ganymede451/kurc-f405/docs/kurc_f405_schematic.pdf

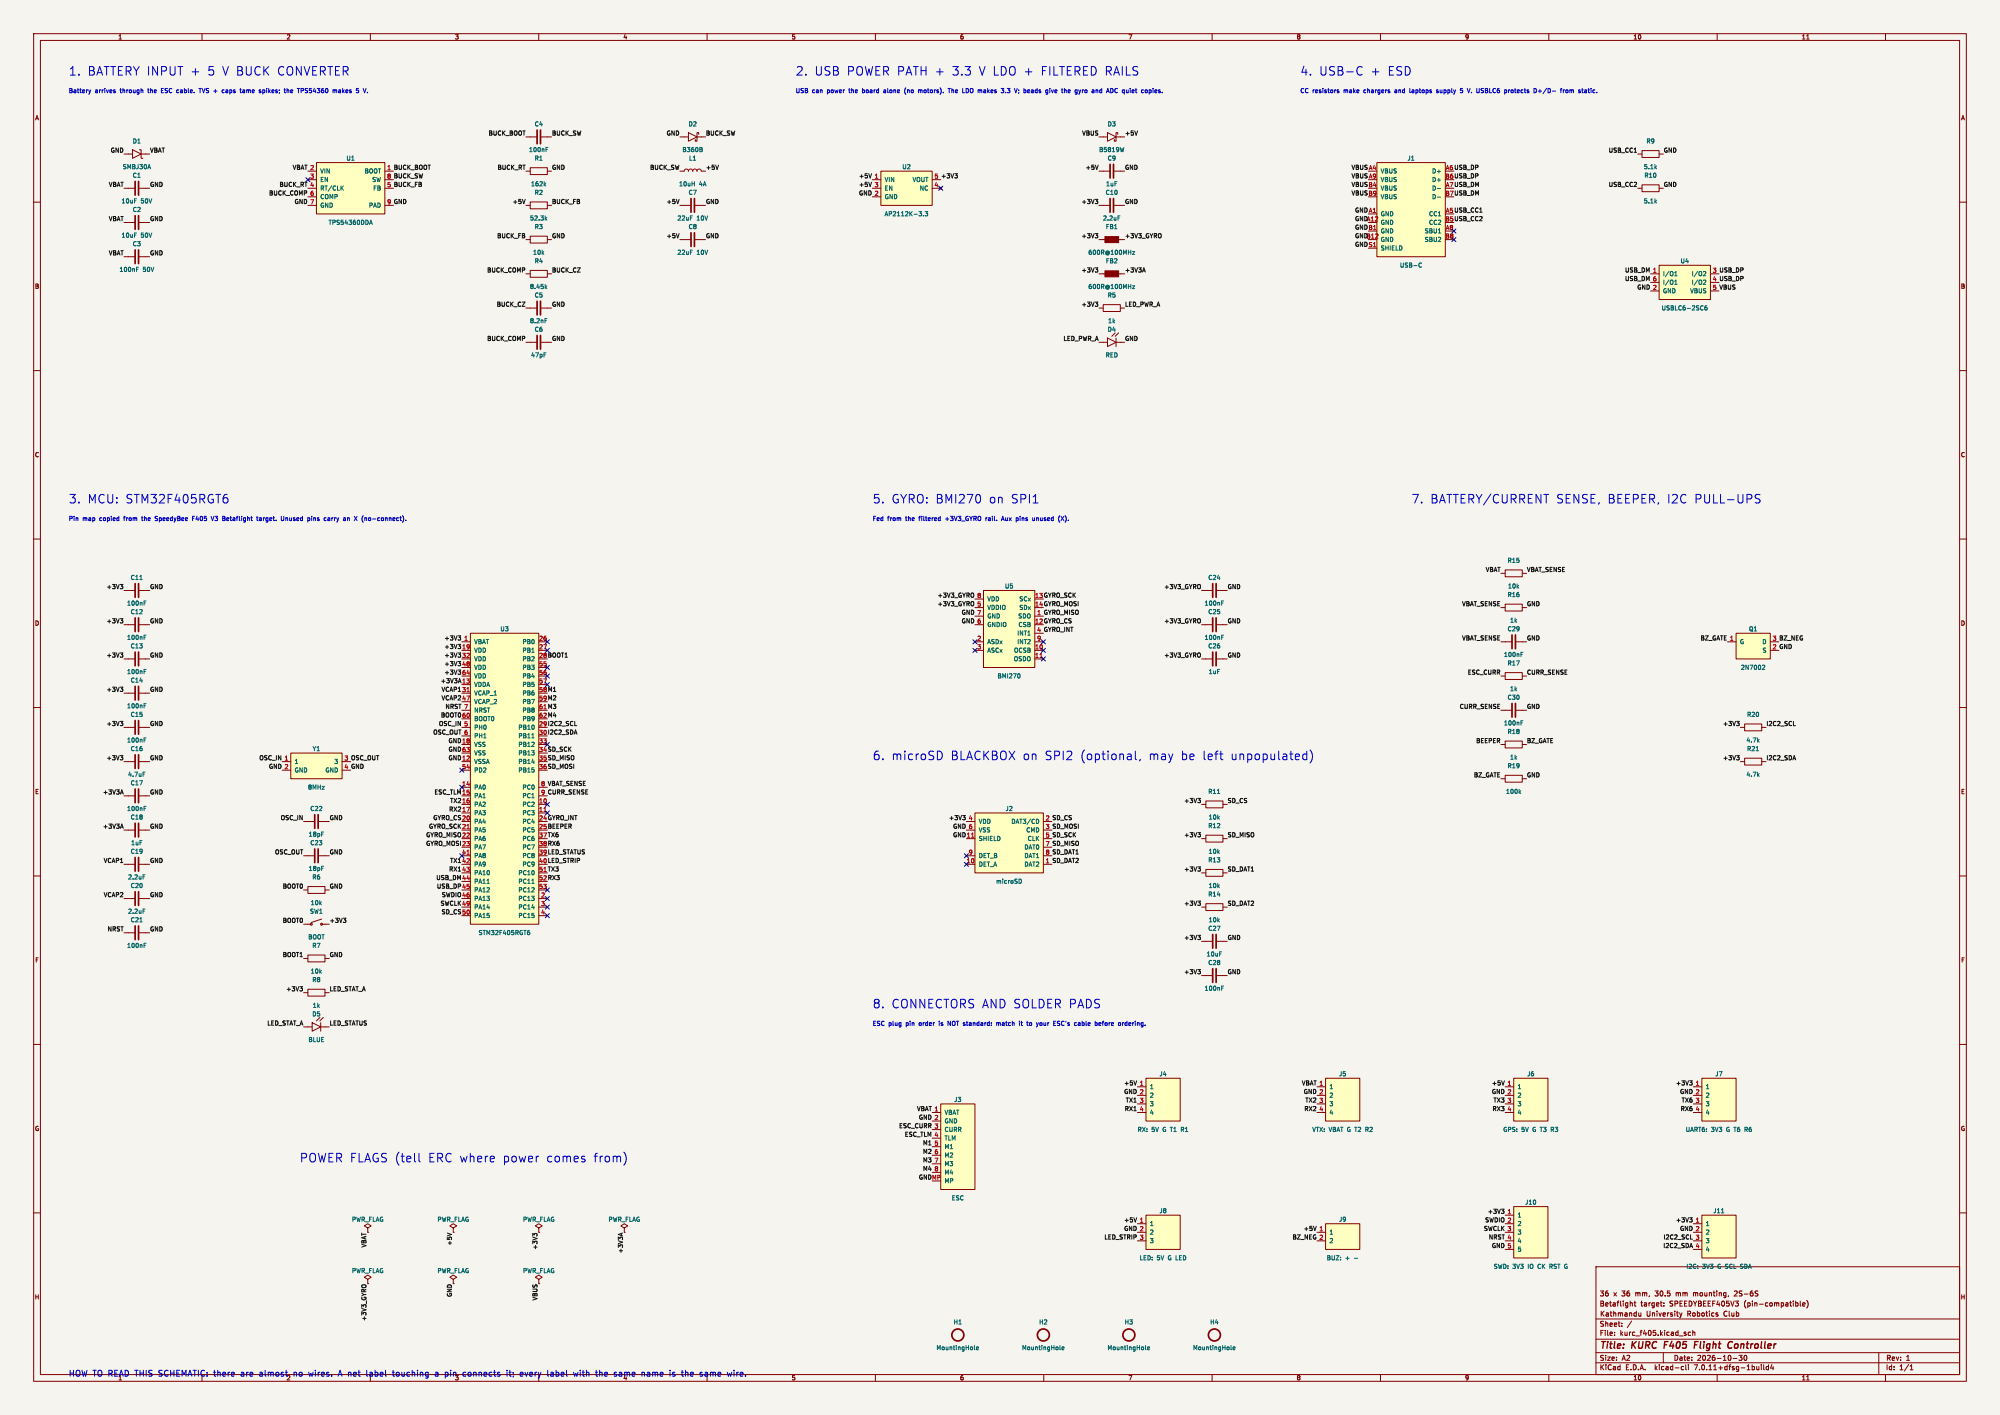
[picture p1: page 1]

1. BATTERY INPUT + 5 V BUCK CONVERTER

GND
GND GND

100k VBAT 1 GND 2 CURR 3 TLM 4 M1 5 M2 6 M3 7 M4 8 MP MP
J2 microSD

8. CONNECTORS AND SOLDER PADS

POWER FLAGS (tell ERC where power comes from)
