ganymede451/kurc-f405/hardware/kurc_f405.kicad_pcb

## KiCad design hardware/kurc_f405.kicad_pcb (2026-11-01)

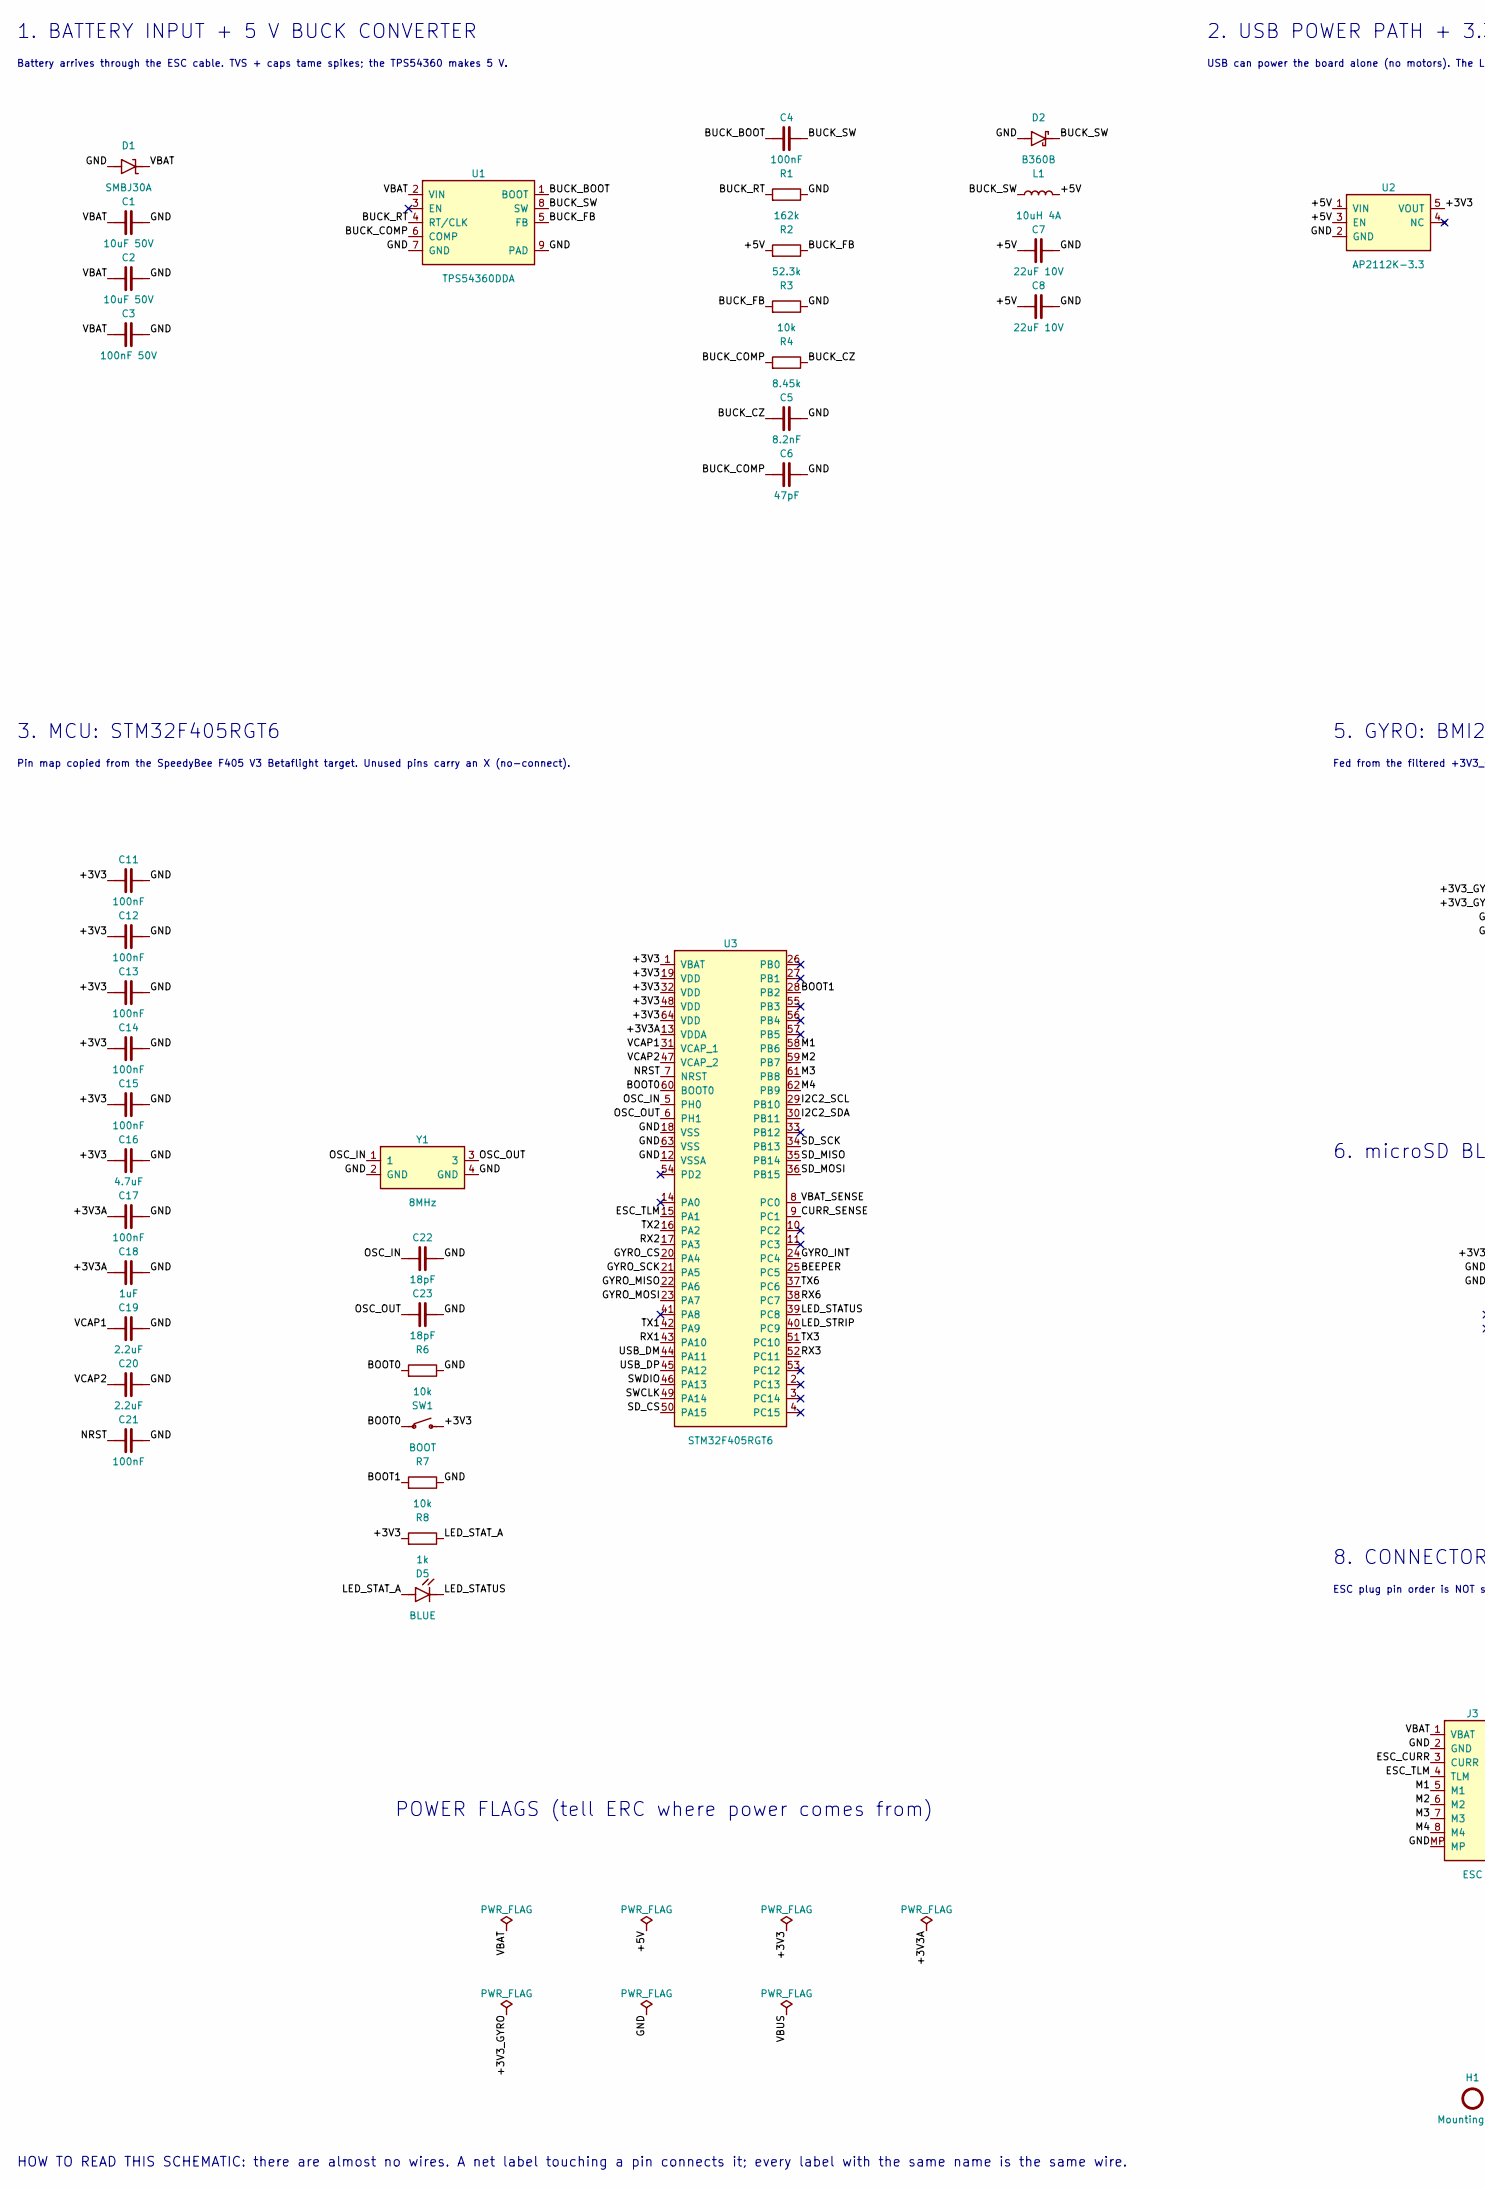
[picture p2: schematic kurc_f405.kicad_sch, KURC F405 Flight Controller, part in row 1, column 1]

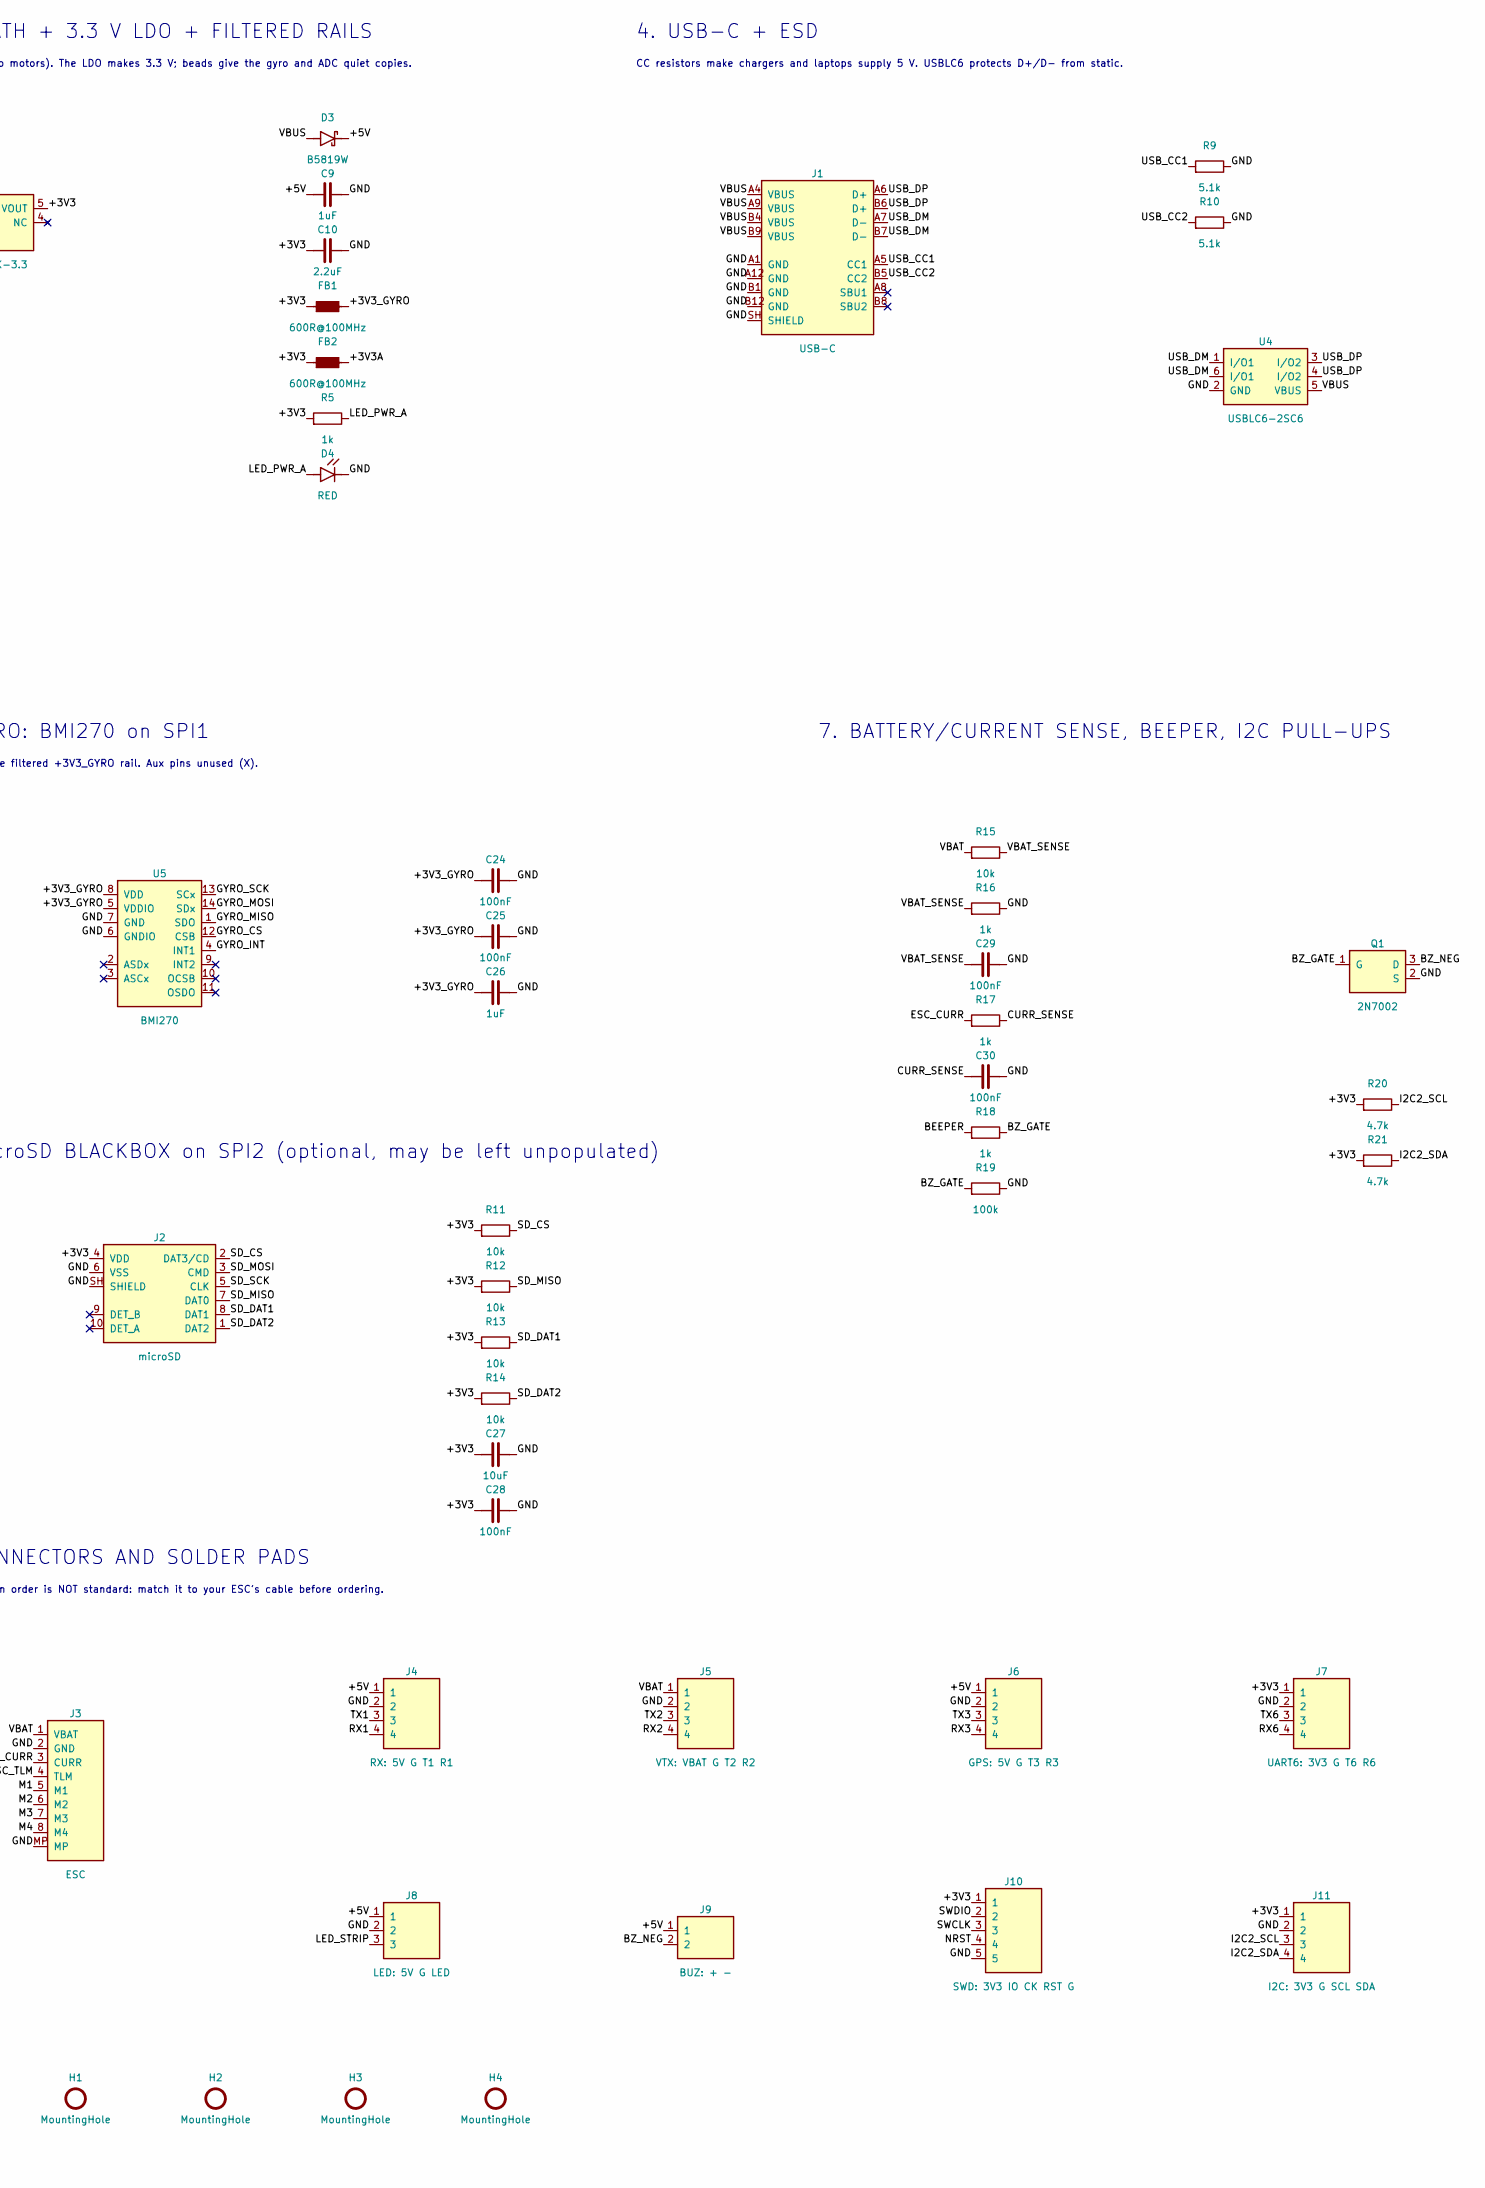
[picture p3: schematic kurc_f405.kicad_sch, KURC F405 Flight Controller, part in row 1, column 2]

Parts:
C1, C2: 10uF 50V; C_1206_3216Metric; MPN 1206 10uF 50V X7R/X5R
C3: 100nF 50V; C_0603_1608Metric; MPN 0603 100nF 50V X7R/X5R
C4: 100nF; C_0603_1608Metric; MPN 0603 100nF X7R/X5R
C5: 8.2nF; C_0402_1005Metric; MPN 0402 8.2nF X7R/X5R
C6: 47pF; C_0402_1005Metric; MPN 0402 47pF X7R/X5R
C7, C8: 22uF 10V; C_0805_2012Metric; MPN 0805 22uF 10V X7R/X5R
C9, C18, C26: 1uF; C_0603_1608Metric; MPN 0603 1uF X7R/X5R
C10, C19, C20: 2.2uF; C_0603_1608Metric; MPN 0603 2.2uF X7R/X5R
C11, C12, C13, C14, C15, C17, C21, C24, C25, C28, C29, C30: 100nF; C_0402_1005Metric; MPN 0402 100nF X7R/X5R
C16: 4.7uF; C_0603_1608Metric; MPN 0603 4.7uF X7R/X5R
C22, C23: 18pF; C_0402_1005Metric; MPN 0402 18pF X7R/X5R
C27: 10uF; C_0805_2012Metric; MPN 0805 10uF X7R/X5R
D1: SMBJ30A; D_SMB; MPN SMBJ30A
D2: B360B; D_SMB; MPN B360B-13-F
D3: B5819W; D_SOD-123; MPN B5819W
D4: RED; LED_0603_1608Metric; MPN 0603 red LED
D5: BLUE; LED_0603_1608Metric; MPN 0603 blue LED
FB1, FB2: 600R@100MHz; L_0603_1608Metric; MPN BLM18PG601SN1D
H1, H2, H3, H4: MountingHole; MountingHole_4.0mm_Grommet
J1: USB-C; USB_C_Receptacle_HRO_TYPE-C-31-M-12; MPN HRO TYPE-C-31-M-12
J2: microSD; microSD_HC_Hirose_DM3AT-SF-PEJM5; MPN Hirose DM3AT-SF-PEJM5
J3: ESC; JST_SH_SM08B-SRSS-TB_1x08-1MP_P1.00mm_Horizontal; MPN JST SM08B-SRSS-TB
J4: RX: 5V G T1 R1; SolderPads_1x04_P2.54mm
J5: VTX: VBAT G T2 R2; SolderPads_1x04_P2.54mm
J6: GPS: 5V G T3 R3; SolderPads_1x04_P2.54mm
J7: UART6: 3V3 G T6 R6; SolderPads_1x04_P2.54mm
J8: LED: 5V G LED; SolderPads_1x03_P2.54mm
J9: BUZ: + -; SolderPads_1x02_P2.54mm
J10: SWD: 3V3 IO CK RST G; SolderPads_1x05_P2.54mm
J11: I2C: 3V3 G SCL SDA; SolderPads_1x04_P2.54mm
L1: 10uH 4A; L_Bourns_SRN8040TA; MPN SRN8040TA-100M
Q1: 2N7002; SOT-23; MPN 2N7002
R1: 162k; R_0603_1608Metric; MPN 0603 162k 1%
R2: 52.3k; R_0603_1608Metric; MPN 0603 52.3k 1%
R3, R6, R7, R11, R12, R13, R14, R15: 10k; R_0603_1608Metric; MPN 0603 10k 1%
R4: 8.45k; R_0603_1608Metric; MPN 0603 8.45k 1%
R5, R8, R16, R17, R18: 1k; R_0603_1608Metric; MPN 0603 1k 1%
R9, R10: 5.1k; R_0603_1608Metric; MPN 0603 5.1k 1%
R19: 100k; R_0603_1608Metric; MPN 0603 100k 1%
R20, R21: 4.7k; R_0603_1608Metric; MPN 0603 4.7k 1%
SW1: BOOT; SW_SPST_PTS810; MPN C&K PTS810 SJM 250 SMTR LFS
U1: TPS54360DDA; TI_SO-PowerPAD-8_ThermalVias; MPN TPS54360DDAR
U2: AP2112K-3.3; SOT-23-5; MPN AP2112K-3.3TRG1
U3: STM32F405RGT6; LQFP-64_10x10mm_P0.5mm; MPN STM32F405RGT6
U4: USBLC6-2SC6; SOT-23-6; MPN USBLC6-2SC6
U5: BMI270; Bosch_LGA-14_3x2.5mm_P0.5mm; MPN BMI270
Y1: 8MHz; Crystal_SMD_3225-4Pin_3.2x2.5mm; MPN 8 MHz 3225 crystal, CL 12 pF

Connections:
/+3V3: C10.1, C11.1, C12.1, C13.1, C14.1, C15.1, C16.1, C27.1, C28.1, FB1.1, FB2.1, J2.4 (VDD), J7.1, J10.1, J11.1, R5.1, R8.1, R11.1, R12.1, R13.1, R14.1, R20.1, R21.1, SW1.2, U2.5 (VOUT), U3.1 (VBAT), U3.19 (VDD), U3.32 (VDD), U3.48 (VDD), U3.64 (VDD)
/+3V3A: C17.1, C18.1, FB2.2, U3.13 (VDDA)
/+3V3_GYRO: C24.1, C25.1, C26.1, FB1.2, U5.5 (VDDIO), U5.8 (VDD)
/+5V: C7.1, C8.1, C9.1, D3.1 (K), J4.1, J6.1, J8.1, J9.1, L1.2, R2.1, U2.1 (VIN), U2.3 (EN)
/BEEPER: R18.1, U3.25 (PC5)
/BOOT0: R6.1, SW1.1, U3.60 (BOOT0)
/BOOT1: R7.1, U3.28 (PB2)
/BUCK_BOOT: C4.1, U1.1 (BOOT)
/BUCK_COMP: C6.1, R4.1, U1.6 (COMP)
/BUCK_CZ: C5.1, R4.2
/BUCK_FB: R2.2, R3.1, U1.5 (FB)
/BUCK_RT: R1.1, U1.4 (RT/CLK)
/BUCK_SW: C4.2, D2.1 (K), L1.1, U1.8 (SW)
/BZ_GATE: Q1.1 (G), R18.2, R19.1
/BZ_NEG: J9.2, Q1.3 (D)
/CURR_SENSE: C30.1, R17.2, U3.9 (PC1)
/ESC_CURR: J3.3 (CURR), R17.1
/ESC_TLM: J3.4 (TLM), U3.15 (PA1)
/GND: C1.2, C2.2, C3.2, C5.2, C6.2, C7.2, C8.2, C9.2, C10.2, C11.2, C12.2, C13.2, C14.2, C15.2, C16.2, C17.2, C18.2, C19.2, C20.2, C21.2, C22.2, C23.2, C24.2, C25.2, C26.2, C27.2, C28.2, C29.2, C30.2, D1.2 (A), D2.2 (A), D4.1 (K), J1.A1 (GND), J1.A12 (GND), J1.B1 (GND), J1.B12 (GND), J1.SH (SHIELD), J2.6 (VSS), J2.SH (SHIELD), J3.2 (GND), J3.MP, J4.2, J5.2, J6.2, J7.2, J8.2, J10.5, J11.2, Q1.2 (S), R1.2, R3.2, R6.2, R7.2, R9.2, R10.2, R16.2, R19.2, U1.7 (GND), U1.9 (PAD), U2.2 (GND), U3.12 (VSSA), U3.18 (VSS), U3.63 (VSS), U4.2 (GND), U5.6 (GNDIO), U5.7 (GND), Y1.2 (GND), Y1.4 (GND)
/GYRO_CS: U3.20 (PA4), U5.12 (CSB)
/GYRO_INT: U3.24 (PC4), U5.4 (INT1)
/GYRO_MISO: U3.22 (PA6), U5.1 (SDO)
/GYRO_MOSI: U3.23 (PA7), U5.14 (SDx)
/GYRO_SCK: U3.21 (PA5), U5.13 (SCx)
/I2C2_SCL: J11.3, R20.2, U3.29 (PB10)
/I2C2_SDA: J11.4, R21.2, U3.30 (PB11)
/LED_PWR_A: D4.2 (A), R5.2
/LED_STATUS: D5.1 (K), U3.39 (PC8)
/LED_STAT_A: D5.2 (A), R8.2
/LED_STRIP: J8.3, U3.40 (PC9)
/M1: J3.5 (M1), U3.58 (PB6)
/M2: J3.6 (M2), U3.59 (PB7)
/M3: J3.7 (M3), U3.61 (PB8)
/M4: J3.8 (M4), U3.62 (PB9)
/NRST: C21.1, J10.4, U3.7 (NRST)
/OSC_IN: C22.1, U3.5 (PH0), Y1.1
/OSC_OUT: C23.1, U3.6 (PH1), Y1.3
/RX1: J4.4, U3.43 (PA10)
/RX2: J5.4, U3.17 (PA3)
/RX3: J6.4, U3.52 (PC11)
/RX6: J7.4, U3.38 (PC7)
/SD_CS: J2.2 (DAT3/CD), R11.2, U3.50 (PA15)
/SD_DAT1: J2.8 (DAT1), R13.2
/SD_DAT2: J2.1 (DAT2), R14.2
/SD_MISO: J2.7 (DAT0), R12.2, U3.35 (PB14)
/SD_MOSI: J2.3 (CMD), U3.36 (PB15)
/SD_SCK: J2.5 (CLK), U3.34 (PB13)
/SWCLK: J10.3, U3.49 (PA14)
/SWDIO: J10.2, U3.46 (PA13)
/TX1: J4.3, U3.42 (PA9)
/TX2: J5.3, U3.16 (PA2)
/TX3: J6.3, U3.51 (PC10)
/TX6: J7.3, U3.37 (PC6)
/USB_CC1: J1.A5 (CC1), R9.1
/USB_CC2: J1.B5 (CC2), R10.1
/USB_DM: J1.A7 (D-), J1.B7 (D-), U3.44 (PA11), U4.1 (I/O1), U4.6 (I/O1)
/USB_DP: J1.A6 (D+), J1.B6 (D+), U3.45 (PA12), U4.3 (I/O2), U4.4 (I/O2)
/VBAT: C1.1, C2.1, C3.1, D1.1 (K), J3.1 (VBAT), J5.1, R15.1, U1.2 (VIN)
/VBAT_SENSE: C29.1, R15.2, R16.1, U3.8 (PC0)
/VBUS: D3.2 (A), J1.A4 (VBUS), J1.A9 (VBUS), J1.B4 (VBUS), J1.B9 (VBUS), U4.5 (VBUS)
/VCAP1: C19.1, U3.31 (VCAP_1)
/VCAP2: C20.1, U3.47 (VCAP_2)

Notes on the sheet:
HOW TO READ THIS SCHEMATIC: there are almost no wires. A net label touching a pin connects it; every label with the same name is the same wire.
5. GYRO: BMI270 on SPI1
6. microSD BLACKBOX on SPI2 (optional, may be left unpopulated)
Battery arrives through the ESC cable. TVS + caps tame spikes; the TPS54360 makes 5 V.
Pin map copied from the SpeedyBee F405 V3 Betaflight target. Unused pins carry an X (no-connect).
7. BATTERY/CURRENT SENSE, BEEPER, I2C PULL-UPS
1. BATTERY INPUT + 5 V BUCK CONVERTER
8. CONNECTORS AND SOLDER PADS
CC resistors make chargers and laptops supply 5 V. USBLC6 protects D+/D- from static.
POWER FLAGS (tell ERC where power comes from)
3. MCU: STM32F405RGT6
4. USB-C + ESD
2. USB POWER PATH + 3.3 V LDO + FILTERED RAILS
USB can power the board alone (no motors). The LDO makes 3.3 V; beads give the gyro and ADC quiet copies.
Fed from the filtered +3V3_GYRO rail. Aux pins unused (X).
ESC plug pin order is NOT standard: match it to your ESC's cable before ordering.

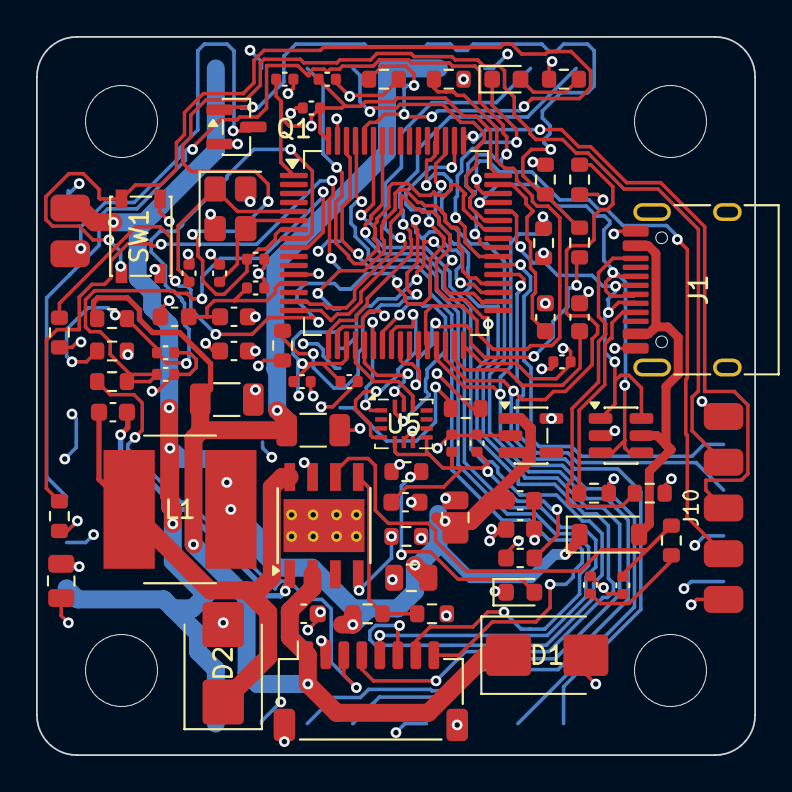
[picture p4: board kurc_f405.kicad_pcb from above]

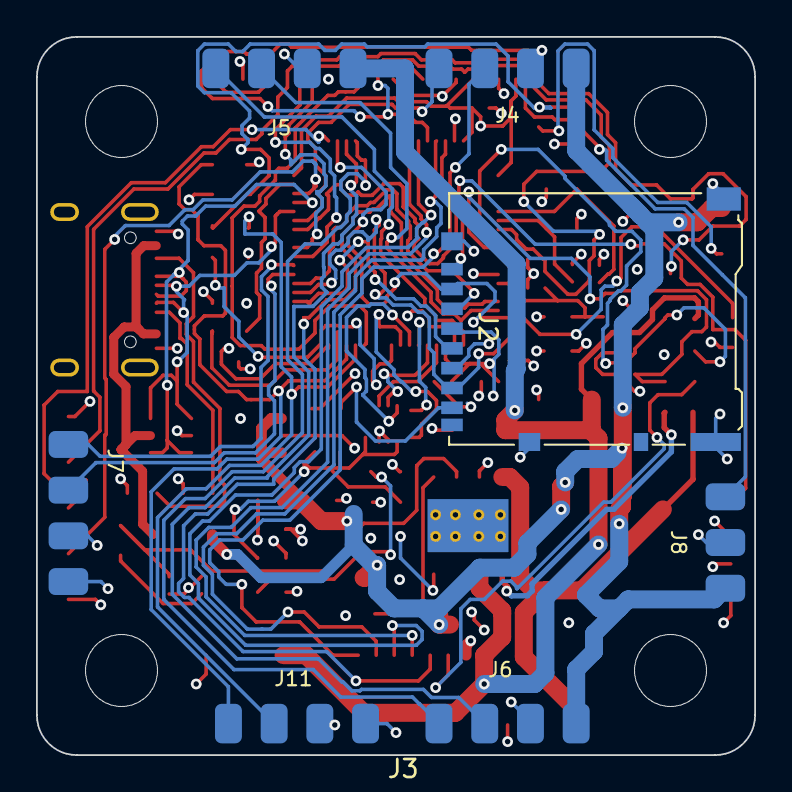
[picture p5: board kurc_f405.kicad_pcb from below]

Board: 4 copper layers, 39.9 x 39.9 mm, 82 parts (7 on the bottom side), 62 nets.
